FunnyParadox/WACCA-Controller/touch_strip_controller/manifacturing_parts/touch_strip_controller.csv

Id | Designator | Footprint | Quantity | Designation | Supplier and ref
1 | C1, C2, C6 | C_0603_1608Metric | 3 | 100nF
2 | C3 | C_1206_3216Metric | 1 | 10uF 10V X7R
3 | C4 | C_1206_3216Metric | 1 | 10uF 25V X7R
4 | C5 | C_0603_1608Metric | 1 | 10nF
5 | D1 | D_SMA | 1 | SMAJ15A
6 | J1 | Amphenol_F32Q-1A7x1-11004_1x04-1MP_P0.5mm_Horizontal | 1 | Conn_01x04_Pin (RS-485)
7 | J2 | Amphenol_F32Q-1A7x1-11008_1x08-1MP_P0.5mm_Horizontal | 1 | F32Q-1A7H1-11008
8 | J3 | Amphenol_F32Q-1A7x1-11012_1x12-1MP_P0.5mm_Horizontal | 1 | F32Q-1A7H1-11012
9 | J4 | PinHeader_1x06_P2.54mm_Vertical | 1 | Conn_PIC_ICSP_ICD
10 | R1, R2, R3, R4 | R_0603_1608Metric | 4 | 1kΩ
11 | R5, R6 | R_0603_1608Metric | 2 | tbdΩ
12 | R7 | R_0603_1608Metric | 1 | 120Ω
13 | R8, R9 | R_0603_1608Metric | 2 | 10kΩ
14 | R10, R11, R12, R13 | R_0603_1608Metric | 4 | 220Ω
15 | R14 | R_0603_1608Metric | 1 | 2kΩ
16 | R15 | R_0603_1608Metric | 1 | 680kΩ
17 | R16 | R_0603_1608Metric | 1 | 100kΩ
18 | U1 | SOIC-28W_7.5x17.9mm_P1.27mm | 1 | PIC18F25K83-I/SO
19 | U2 | SOIC-8_3.9x4.9mm_P1.27mm | 1 | TI-THVD1500
20 | U3 | Converter_DCDC_Murata_OKI-78SR_Vertical | 1 | OKI-78SR-5/1.5-W36-C
21 | U4 | TI_SO-PowerPAD-8_ThermalVias | 1 | TPS259621
