FunnyParadox/WACCA-Controller/Side Panel Zone Separation Front.dxf

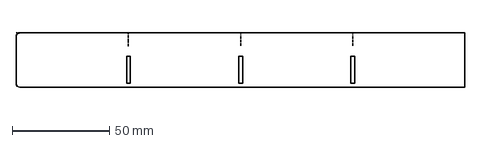
[picture p1: CAD file, 2026-09-19]
Side Panel Zone Separation Front.dxf
231.2 x 28.0 mm
