FunnyParadox/WACCA-Controller/(list of files, cad)

Other CAD files:
Individual Module.f3d
WACCA_Controller.f3d
