FunnyParadox/WACCA-Controller/(list of files, drawings)

Other design files:
touch_strip_controller/TPS259621_PSpice_Model/TPS259621_TRANS.dsn
touch_strip_controller/TPS259621_PSpice_Model/TPS259621_TRANS.olb
touch_strip_controller/TPS259621_PSpice_Model/TPS259621_TRANS.opj
