FunnyParadox/WACCA-Controller/touch_strip_controller/touch_strip_controller.kicad_pcb

## KiCad design touch_strip_controller/touch_strip_controller.kicad_pcb (2026-09-19)

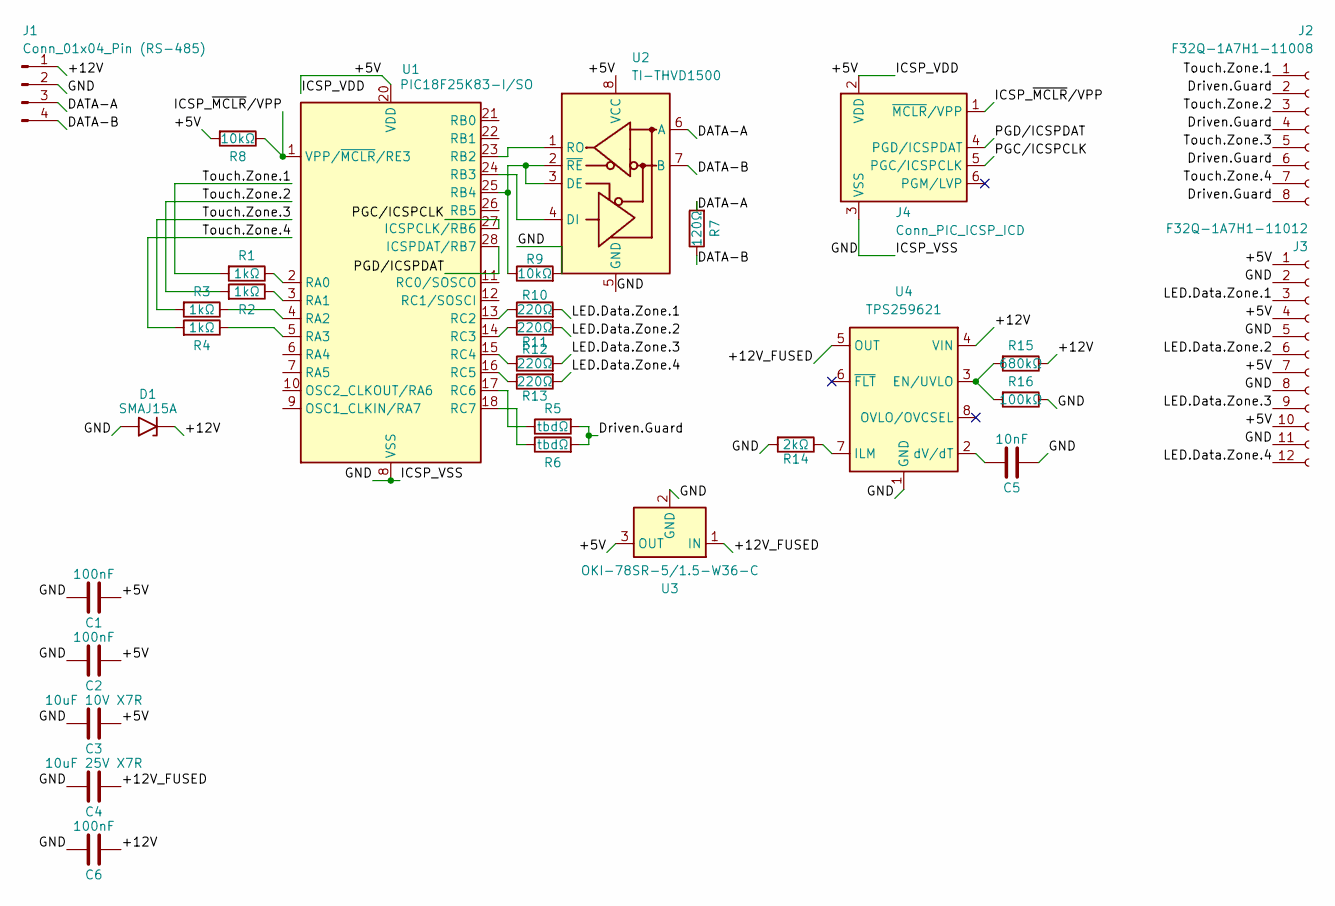
[picture p2: schematic touch_strip_controller.kicad_sch]

Parts:
C1, C2, C6: 100nF; C_0603_1608Metric
C3: 10uF 10V X7R; C_1206_3216Metric
C4: 10uF 25V X7R; C_1206_3216Metric
C5: 10nF; C_0603_1608Metric
D1: SMAJ15A; D_SMA
J1: Conn_01x04_Pin (RS-485); Amphenol_F32Q-1A7x1-11004_1x04-1MP_P0.5mm_Horizontal
J2: F32Q-1A7H1-11008; Amphenol_F32Q-1A7x1-11008_1x08-1MP_P0.5mm_Horizontal
J3: F32Q-1A7H1-11012; Amphenol_F32Q-1A7x1-11012_1x12-1MP_P0.5mm_Horizontal
J4: Conn_PIC_ICSP_ICD; PinHeader_1x06_P2.54mm_Vertical
R1, R2, R3, R4: 1kΩ; R_0603_1608Metric
R5, R6: tbdΩ; R_0603_1608Metric
R7: 120Ω; R_0603_1608Metric
R8, R9: 10kΩ; R_0603_1608Metric
R10, R11, R12, R13: 220Ω; R_0603_1608Metric
R14: 2kΩ; R_0603_1608Metric
R15: 680kΩ; R_0603_1608Metric
R16: 100kΩ; R_0603_1608Metric
U1: PIC18F25K83-I/SO; SOIC-28W_7.5x17.9mm_P1.27mm
U2: TI-THVD1500; SOIC-8_3.9x4.9mm_P1.27mm
U3: OKI-78SR-5/1.5-W36-C; Converter_DCDC_Murata_OKI-78SR_Vertical
U4: TPS259621; TI_SO-PowerPAD-8_ThermalVias

Connections:
/+5V: C1.1, C2.1, C3.1, J3.1, J3.4, J3.7, J3.10, J4.2 (VDD), R8.2, U1.20 (VDD), U2.8 (VCC), U3.3 (OUT)
/+12V: C6.2, D1.1 (A1), J1.1, R15.1, U4.4 (VIN)
/+12V_FUSED: C4.1, U3.1 (IN), U4.5 (OUT)
/DATA-A: J1.3, R7.2, U2.6 (A)
/DATA-B: J1.4, R7.1, U2.7 (B)
/Driven.Guard: J2.2, J2.4, J2.6, J2.8, R5.2, R6.2
/GND: C1.2, C2.2, C3.2, C4.2, C5.2, C6.1, D1.2 (A2), J1.2, J3.2, J3.5, J3.8, J3.11, J4.3 (VSS), R9.2, R14.2, R16.1, U1.8 (VSS), U1.19 (VSS), U2.5 (GND), U3.2 (GND), U4.1 (GND), U4.9 (GND)
/ICSP_~MCLR/VPP: J4.1 (~MCLR/VPP), R8.1, U1.1 (VPP/~MCLR/RE3)
/LED.Data.Zone.1: J3.3, R10.2
/LED.Data.Zone.2: J3.6, R11.2
/LED.Data.Zone.3: J3.9, R12.2
/LED.Data.Zone.4: J3.12, R13.2
/PGC/ICSPCLK: J4.5 (PGC/ICSPCLK), U1.27 (ICSPCLK/RB6)
/PGD/ICSPDAT: J4.4 (PGD/ICSPDAT), U1.28 (ICSPDAT/RB7)
/Touch.Zone.1: J2.1, R1.2
/Touch.Zone.2: J2.3, R2.2
/Touch.Zone.3: J2.5, R3.2
/Touch.Zone.4: J2.7, R4.2
unnamed: R1.1, U1.2 (RA0)
unnamed: R2.1, U1.3 (RA1)
unnamed: R3.1, U1.4 (RA2)
unnamed: R4.1, U1.5 (RA3)
unnamed: U1.23 (RB2), U2.1 (RO)
unnamed: U1.24 (RB3), U2.4 (DI)
unnamed: R9.1, U1.25 (RB4), U2.2 (~RE), U2.3 (DE)
unnamed: R10.1, U1.13 (RC2)
unnamed: R11.1, U1.14 (RC3)
unnamed: R12.1, U1.15 (RC4)
unnamed: R13.1, U1.16 (RC5)
unnamed: R5.1, U1.17 (RC6)
unnamed: R6.1, U1.18 (RC7)
unnamed: R15.2, R16.2, U4.3 (EN/UVLO)
unnamed: R14.1, U4.7 (ILM)
unnamed: C5.1, U4.2 (dV/dT)

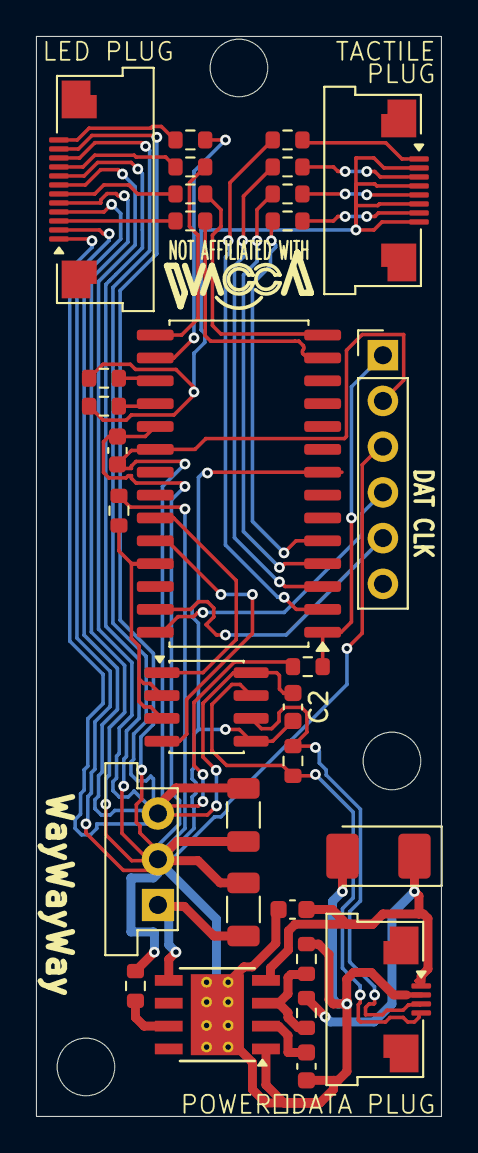
[picture p3: board touch_strip_controller.kicad_pcb from above]

Board: 2 copper layers, 22.5 x 60.0 mm, 31 parts (0 on the bottom side), 34 nets.
