FunnyParadox/WACCA-Controller/software/firmware/common/image_layout.h

#ifndef WACCA_IMAGE_LAYOUT_H
#define WACCA_IMAGE_LAYOUT_H
// Shared by C, the linker-script preprocessor and the image packager.
#define WACCA_RAM_BASE 0x20000000
#define WACCA_RAM_SIZE 0x5000
#define WACCA_BOOT_REQUEST_SIZE 16
#define WACCA_FLASH_BASE 0x08000000
#define WACCA_FLASH_SIZE 0x10000
#define WACCA_FLASH_PAGE 0x1000
#define WACCA_BOOT_SIZE 0x4000
#define WACCA_APP_OFFSET WACCA_BOOT_SIZE
#define WACCA_METADATA_OFFSET 0xF000
#define WACCA_APP_CAPACITY (WACCA_METADATA_OFFSET - WACCA_APP_OFFSET)
#define WACCA_IMAGE_LAYOUT_ID 0x00010001
#define WACCA_IMAGE_HEADER_SIZE 32
#define WACCA_IMAGE_COMMIT 0x50414357
#define WACCA_UPDATE_CHUNK 256
#endif
